ddintrono1/Circuit_Analyser/step.csv

Time[s] | Voltage[V]
0 | 0.0121
0.0001 | 0.0024
0.0002 | 0.0121
0.00030000000000000003 | 0.0113
0.0004 | 0.0193
0.0005 | 0.0210
0.0006000000000000001 | 0.0274
0.0007000000000000001 | 0.0250
0.0008000000000000001 | 0.0371
0.0009000000000000002 | 0.0322
0.0010000000000000002 | 0.0451
0.0011000000000000003 | 0.0435
0.0012000000000000003 | 0.0419
0.0013000000000000004 | 0.0492
0.0014000000000000004 | 0.0621
0.0015000000000000005 | 0.0604
0.0016000000000000005 | 0.0653
0.0017000000000000006 | 0.0645
0.0018000000000000006 | 0.0677
0.0019000000000000006 | 0.0830
0.0020000000000000005 | 0.0766
0.0021000000000000003 | 0.0741
0.0022 | 0.0790
0.0023 | 0.0862
0.0024 | 0.0854
0.0024999999999999996 | 0.0943
0.0025999999999999994 | 0.0919
0.0026999999999999993 | 0.0886
0.002799999999999999 | 0.1023
0.002899999999999999 | 0.1023
0.0029999999999999988 | 0.1096
0.0030999999999999986 | 0.1072
0.0031999999999999984 | 0.1120
0.0032999999999999982 | 0.1209
0.003399999999999998 | 0.1209
0.003499999999999998 | 0.1217
0.0035999999999999977 | 0.1289
0.0036999999999999976 | 0.1330
0.0037999999999999974 | 0.1362
0.0038999999999999972 | 0.1418
0.0039999999999999975 | 0.1442
0.004099999999999998 | 0.1491
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
