ddintrono1/Circuit_Analyser/Core/Src/main.c

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
/* Includes ------------------------------------------------------------------*/
#include "main.h"

/* USER CODE BEGIN Includes */
#include <math.h>
#include <stdio.h>
#include <string.h>
#include <stdlib.h>

/* USER CODE END Includes */

/* USER CODE BEGIN PTD */
typedef enum {
    MODE_IDLE,
    MODE_STEP_LAUNCH,
    MODE_WAVE_LAUNCH,
	MODE_STEP_RUNNING,
	MODE_FREQ_RUNNING
} SystemState_t;

/* USER CODE END PTD */

/* USER CODE BEGIN PD */
#define STEP_SAMPLES 2000
#define LUT_SAMPLES 1000
// Received command buffer size
#define RX_BUFFER_SIZE 32
// Binary protocol mode headers
#define BIN_HEADER_1 0xAA
#define BIN_HEADER_2 0xBB
#define BIN_MODE_STEP 0x01
#define BIN_MODE_FREQ 0x02

// Board timers frequency
#define MCU_TIMER_CLOCK_FREQ 84000000

// Transmission variables (ping-pong buffer)
#define CHUNK_SIZE (2*LUT_SAMPLES)
#define TOTAL_BUFFER_SIZE (2*CHUNK_SIZE)

/* USER CODE END PD */

ADC_HandleTypeDef hadc1;
ADC_HandleTypeDef hadc2;
DMA_HandleTypeDef hdma_adc1;
DMA_HandleTypeDef hdma_adc2;

DAC_HandleTypeDef hdac;
DMA_HandleTypeDef hdma_dac1;

TIM_HandleTypeDef htim2;
TIM_HandleTypeDef htim8;

UART_HandleTypeDef huart2;
DMA_HandleTypeDef hdma_usart2_tx;

/* USER CODE BEGIN PV */
volatile uint16_t ADC_buffer[TOTAL_BUFFER_SIZE];
uint16_t DAC_Sine[LUT_SAMPLES];
uint16_t DAC_Saw[LUT_SAMPLES];
uint16_t* current_waveform_ptr = DAC_Sine;

// System state initialization
SystemState_t current_state = MODE_IDLE;

// UART command reception variables
uint8_t rx_byte;              	// current byte
char rx_buffer[RX_BUFFER_SIZE]; // complete command buffer
uint8_t rx_index = 0;			// current byte index

// UART data transmission header
const uint8_t header_seq[2] = {BIN_HEADER_1, BIN_HEADER_2};

/* USER CODE END PV */

void SystemClock_Config(void);
static void MX_GPIO_Init(void);
static void MX_DMA_Init(void);
static void MX_USART2_UART_Init(void);
static void MX_ADC1_Init(void);
static void MX_TIM2_Init(void);
static void MX_DAC_Init(void);
static void MX_ADC2_Init(void);
static void MX_TIM8_Init(void);
/**
  * @brief  The application entry point.
  * @retval int
  */
int main(void)
{

  /* MCU Configuration--------------------------------------------------------*/

  /* Reset of all peripherals, Initializes the Flash interface and the Systick. */
  HAL_Init();

  /* Configure the system clock */
  SystemClock_Config();

  /* Initialize all configured peripherals */
  MX_GPIO_Init();
  MX_DMA_Init();
  MX_USART2_UART_Init();
  MX_ADC1_Init();
  MX_TIM2_Init();
  MX_DAC_Init();
  MX_ADC2_Init();
  MX_TIM8_Init();
  /* USER CODE BEGIN 2 */

  // Create one sine period LookUpTable
  for (int i = 0; i < LUT_SAMPLES; i++){
	  DAC_Sine[i] = (uint16_t)((4095.0f/2.0f) * (1.0f + sin(2.0f*M_PI*i/LUT_SAMPLES)));
  }

  // Create Sawtooth LookUpTable
  for(int i = 0; i < LUT_SAMPLES; i++){
	  DAC_Saw[i] = (uint16_t)(4095.0f/(LUT_SAMPLES-1)*i);
  }

  // Trigger connection with the user
  HAL_UART_Receive_IT(&huart2, &rx_byte, 1);

  /* USER CODE END 2 */

  /* Infinite loop */
  /* USER CODE BEGIN WHILE */
  while (1)
  {
	  // Start step response routine
	  if (current_state == MODE_STEP_LAUNCH)stepResponse();

	  // Start frequency analysis routine
	  if (current_state == MODE_WAVE_LAUNCH)waveformResponse();

    /* USER CODE END WHILE */

    /* USER CODE BEGIN 3 */
  }
  /* USER CODE END 3 */
}

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
/* USER CODE BEGIN 4 */

/*
 * The ADC conversion complete callback is called when the whole ADC buffer has
 * been filled with conversions.
 * For the step response, which is a one shot event, the code in this callback
 * reasonably stops the conversion and sends the whole buffer to the PC.
 * For the frequency response, this callback handles the 'PONG' part of the buffer
 * transmission, sending the second half of the ADC conversion buffer, without
 * interrupting the conversion, as we want to continuously measure voltage.
*/
void HAL_ADC_ConvCpltCallback(ADC_HandleTypeDef* hadc)
{
	if (current_state == MODE_IDLE) return;

    // Handles STEP, measured on ADC1
    if (hadc->Instance == ADC1)
    {
        // Stop conversion (One-Shot)
        HAL_TIM_Base_Stop(&htim2);
        HAL_ADC_Stop_DMA(&hadc1);

        // Send the measurements
        sendData(&ADC_buffer[0], STEP_SAMPLES, BIN_MODE_STEP);

        // Reset system state
        current_state = MODE_IDLE;
    }

    // Handles frequency response, measured on ADC2
    if (hadc->Instance == ADC2)
    {
        // Send only the second part of the buffer, without stopping the conversion
        sendData(&ADC_buffer[TOTAL_BUFFER_SIZE/2], TOTAL_BUFFER_SIZE/2, BIN_MODE_FREQ);
    }
}

/*
 * This callback handles the 'PING' part of the buffer transmission, sending the
 * first half of the ADC conversion buffer, without  interrupting the conversion,
 * as we want to continuously measure voltage.
 */
void HAL_ADC_ConvHalfCpltCallback(ADC_HandleTypeDef* hadc)
{
    if (hadc->Instance == ADC2)
    {
    	// Send only the first part of the buffer, without stopping the conversion
        sendData(&ADC_buffer[0], TOTAL_BUFFER_SIZE/2, BIN_MODE_FREQ);
    }
}

/*
 * This callback handles the command reception. Every received byte is stored in an array,
 * when a line terminator is received, the whole command, stored in the array is parsed and
 * the system state is updated accordingly
 */
void HAL_UART_RxCpltCallback(UART_HandleTypeDef *huart)
{
	if(huart->Instance == USART2){

		// Check if a line terminator has been sent, indicating a complete command
		if (rx_byte == '\n' || rx_byte == '\r'){
			// Close the string with the null terminator
			rx_buffer[rx_index] = '\0';

			if (rx_buffer[0] == 'S'){
				current_state = MODE_STEP_LAUNCH;
			}

			if (rx_buffer[0] == 'F'){
				// Extract the numerical values from the buffer, stopping at the terminator "\n"
				int freq_val = atoi(&rx_buffer[1]);
				changeFreq(freq_val);
				current_waveform_ptr = DAC_Sine;
				current_state = MODE_WAVE_LAUNCH;
			}
			if(rx_buffer[0] == 'T'){
				int freq_val = atoi(&rx_buffer[1]);
				changeFreq(freq_val);
				current_waveform_ptr = DAC_Saw;
				current_state = MODE_WAVE_LAUNCH;
			}

			if (rx_buffer[0] == 'A'){
				// Reset system state
				current_state = MODE_IDLE;

				// Stop everything
				HAL_TIM_Base_Stop(&htim2);
				HAL_TIM_Base_Stop(&htim8);
				HAL_ADC_Stop_DMA(&hadc1);
				setPinMode(STEP_GPIO_Port, STEP_Pin, GPIO_MODE_INPUT);
				HAL_ADC_Stop_DMA(&hadc2);
				HAL_DAC_Stop_DMA(&hdac, DAC_CHANNEL_1);
				setPinMode(DAC_GPIO_Port, DAC_Pin, GPIO_MODE_INPUT);

			}
			rx_index = 0;
		}
		else{
			// Buffer overflow protection
			if (rx_index < RX_BUFFER_SIZE){
				rx_buffer[rx_index] = rx_byte;
				rx_index++;
			}
		}
		HAL_UART_Receive_IT(&huart2, &rx_byte, 1);
	}
}

void stepResponse(void)
{
	// Update state
	current_state = MODE_STEP_RUNNING;

	// Configure the DAC pin to analog input to avoid short circuits
	setPinMode(DAC_GPIO_Port, DAC_Pin, GPIO_MODE_INPUT);

	// Configure the step pin to digital output in order to produce the step signal
	setPinMode(STEP_GPIO_Port, STEP_Pin, GPIO_MODE_OUTPUT_PP);

	// Wait to ensure the capacitor is fully discharged
	HAL_GPIO_WritePin(GPIOA, GPIO_PIN_15, GPIO_PIN_RESET);
	HAL_Delay(500);

	// Start DMA ADC conversion, still waiting for the timer trigger
	HAL_ADC_Start_DMA(&hadc1, (uint32_t*)ADC_buffer, STEP_SAMPLES);

	// Start the timer that triggers the ADC conversion
	HAL_TIM_Base_Start(&htim2);

	// Send a voltage step to the circuit
	HAL_GPIO_WritePin(GPIOA, GPIO_PIN_15, GPIO_PIN_SET);
}

void waveformResponse(void)
{
	// Update state
	current_state = MODE_FREQ_RUNNING;

	// Configure the step pin to analog input to avoid short circuits
	setPinMode(STEP_GPIO_Port, STEP_Pin, GPIO_MODE_INPUT);

	// Configure the DAC pin to analog output in order to produce the sine signal
	setPinMode(DAC_GPIO_Port, DAC_Pin, GPIO_MODE_ANALOG);

	// Start DMA DAC, still waiting for the timer trigger
	HAL_DAC_Start_DMA(&hdac, DAC_CHANNEL_1, (uint32_t*) current_waveform_ptr, LUT_SAMPLES, DAC_ALIGN_12B_R);

	// Start DMA ADC conversion, still waiting for the timer trigger
	HAL_ADC_Start_DMA(&hadc2, (uint32_t*)ADC_buffer, TOTAL_BUFFER_SIZE);

	// Start the timer that triggers the ADC and DAC
	HAL_TIM_Base_Start(&htim8);
}

void sendData(volatile uint16_t* buffer, uint16_t buffer_length, uint8_t mode)
{
    // Check if the UART is idle, otherwise skip
    if (huart2.gState != HAL_UART_STATE_READY) return;

    // Send chunk header + mode header
    HAL_UART_Transmit(&huart2, (uint8_t*)header_seq, 2, 1);
    HAL_UART_Transmit(&huart2, &mode, 1, 1);

    // Send ADC data through DMA
    HAL_UART_Transmit_DMA(&huart2, (uint8_t*)buffer, buffer_length * 2);
}

/*
 *  Wrapper function used to switch pins configuration mode
 */
void setPinMode(GPIO_TypeDef* GPIOx, uint16_t GPIO_Pin, uint32_t Mode)
{
    GPIO_InitTypeDef GPIO_InitStruct = {0};

    GPIO_InitStruct.Pin = GPIO_Pin;
    GPIO_InitStruct.Mode = Mode;
    GPIO_InitStruct.Pull = GPIO_NOPULL;
    GPIO_InitStruct.Speed = GPIO_SPEED_FREQ_LOW;

    HAL_GPIO_Init(GPIOx, &GPIO_InitStruct);
}

/*
 * Wrapper function used to change waveforms
 */
void changeFreq(uint16_t sine_freq)
{
	// Avoid too high, null or negative frequencies
	if (sine_freq > 2 && sine_freq <= 200){

		uint16_t new_ARR = (uint16_t) ((MCU_TIMER_CLOCK_FREQ / ((uint32_t)sine_freq*LUT_SAMPLES)) - 1);
		__HAL_TIM_SET_AUTORELOAD(&htim8, new_ARR);
		htim8.Instance->EGR = TIM_EGR_UG;
	}

}

/* USER CODE END 4 */
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
