ddintrono1/Circuit_Analyser/(commit log)

2025-11-27 Added python files, measurements results file
    Added python file to extract data serially transmitted by the controller using UART. Added another python file used to process the data in order to estimate the RC circuit parameters. The measurement CSV file is also been saved in the folder
    [adc_data.csv]
2025-11-28 Added different modes logic
    The firmware has been modified to implement two different working logics: one is the already implemented step response capture, the other, still not implemented, is the frequency analysis logic. The hardware has been configured (DAC and ADC) to further implement the frequency analysis.
2025-12-01 Implemented frequency analysis
    A routine which feeds a sinusoidal signal to the circuit and measures the output voltage has been implemented.
    [adc_freq_data.csv]
2025-12-01 Implemented gui app to control the measurements
    A graphical interface has been implemented to control the measurements, allowing to select which measurement to perform (step response or frequency analysis) and simplyifing connection with the Nucleo Board
2025-12-07 Implemented real time data plot
    Implemented real time data plot to mimic the oscilloscope functioning
    [adc_data.csv, adc_freq_data.csv]
2025-12-11 Stop logic implemented, improved interrupt priorities
2025-12-14 Uploaded project material
    [Datalog_0.csv, sawtooth.csv, sine.csv, step.csv]
